nvasquezc/dc-motor-fault-detection/docs/fig01_caracteristica.png

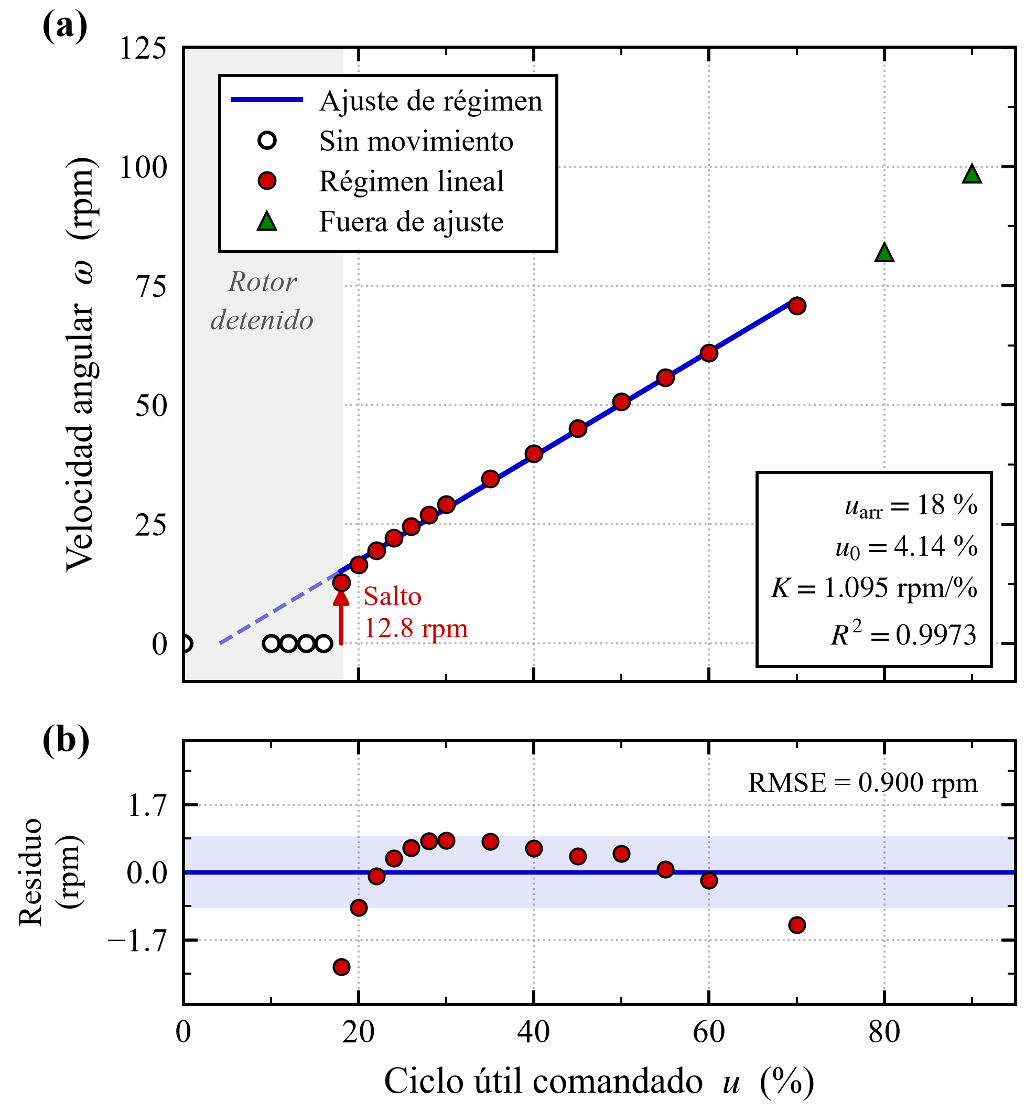
docs/fig01_caracteristica.png
