nvasquezc/dc-motor-fault-detection/docs/fig02_metrologia.png

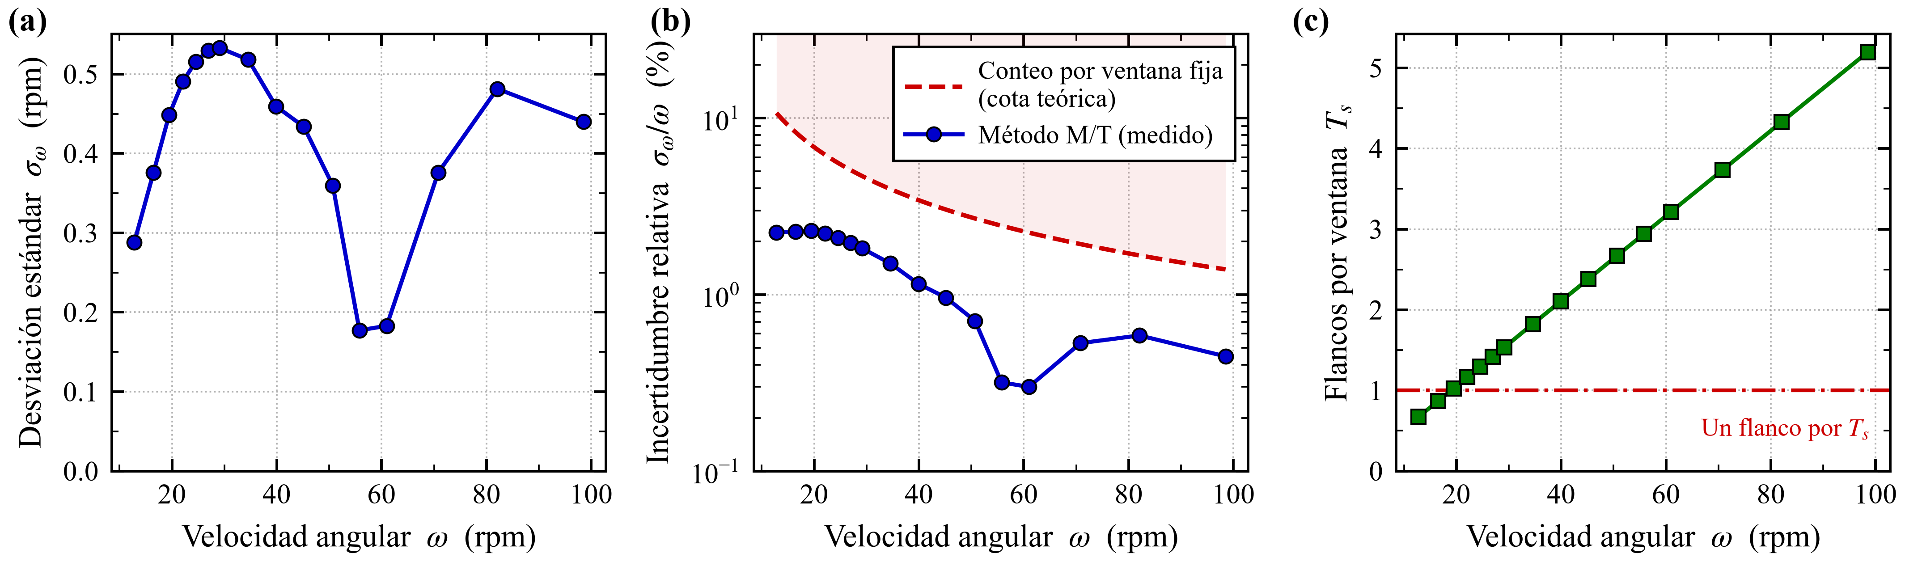
docs/fig02_metrologia.png
