nvasquezc/dc-motor-fault-detection/docs/fig03_escalon.png

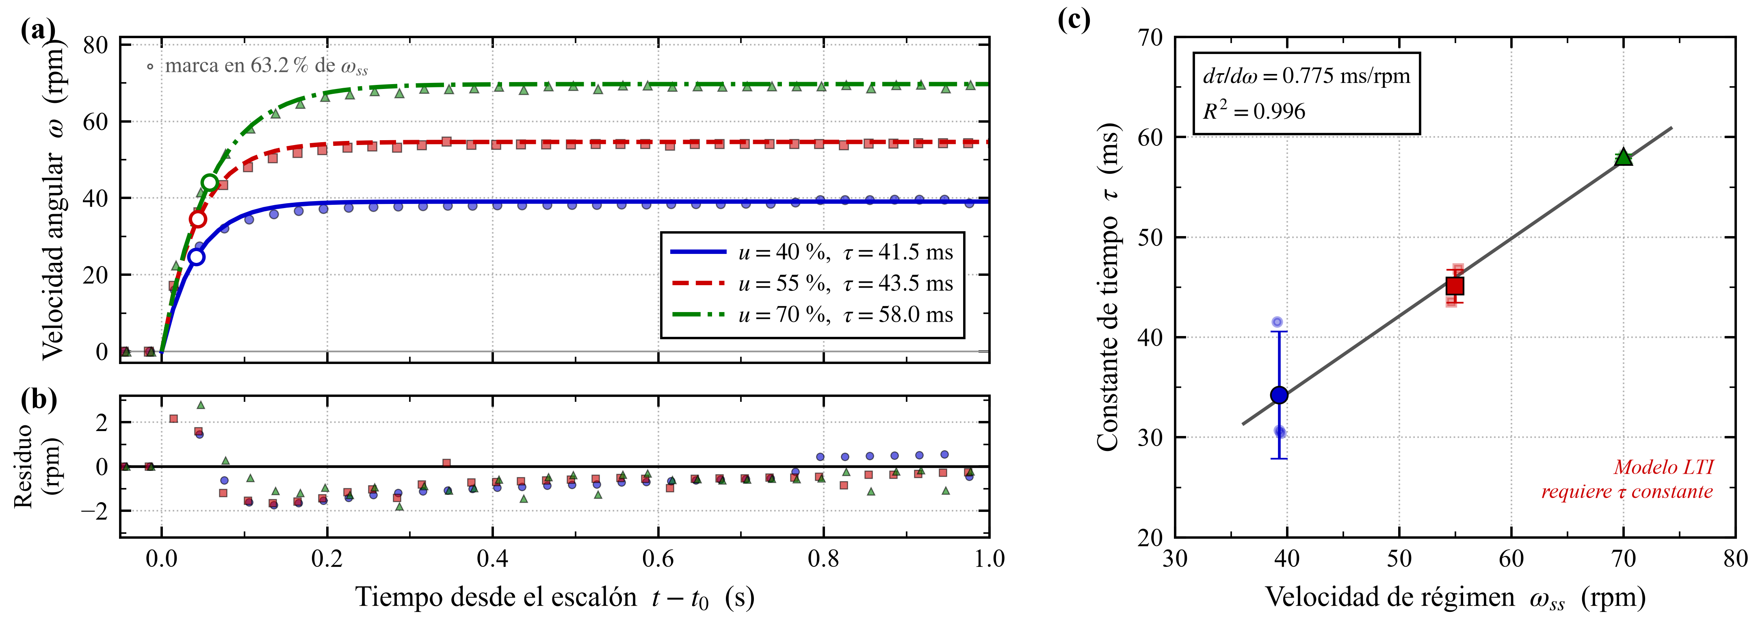
docs/fig03_escalon.png
