nvasquezc/dc-motor-fault-detection/docs/fig04_deriva1.png

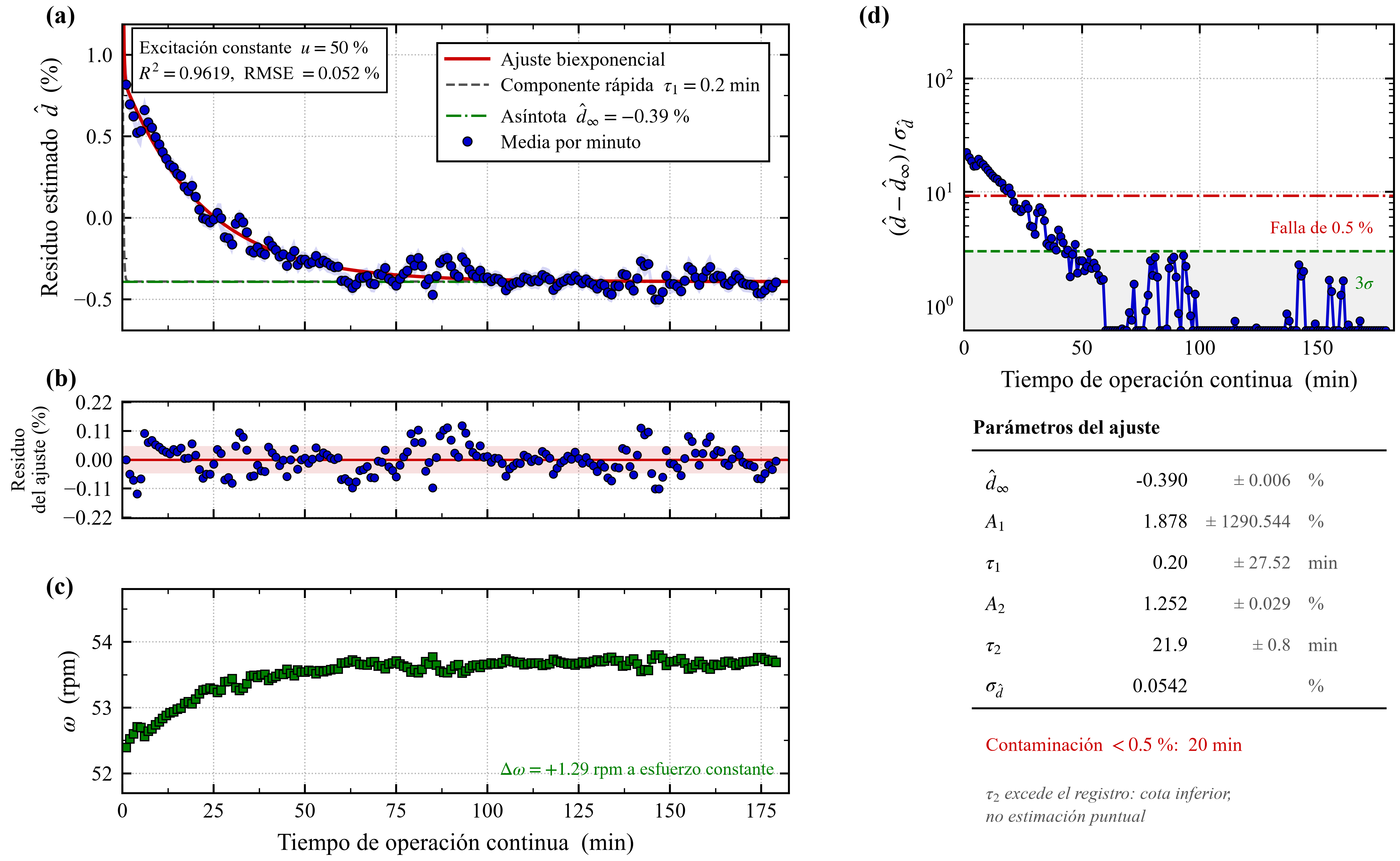
docs/fig04_deriva1.png
