nvasquezc/dc-motor-fault-detection/docs/fig04_deriva2.png

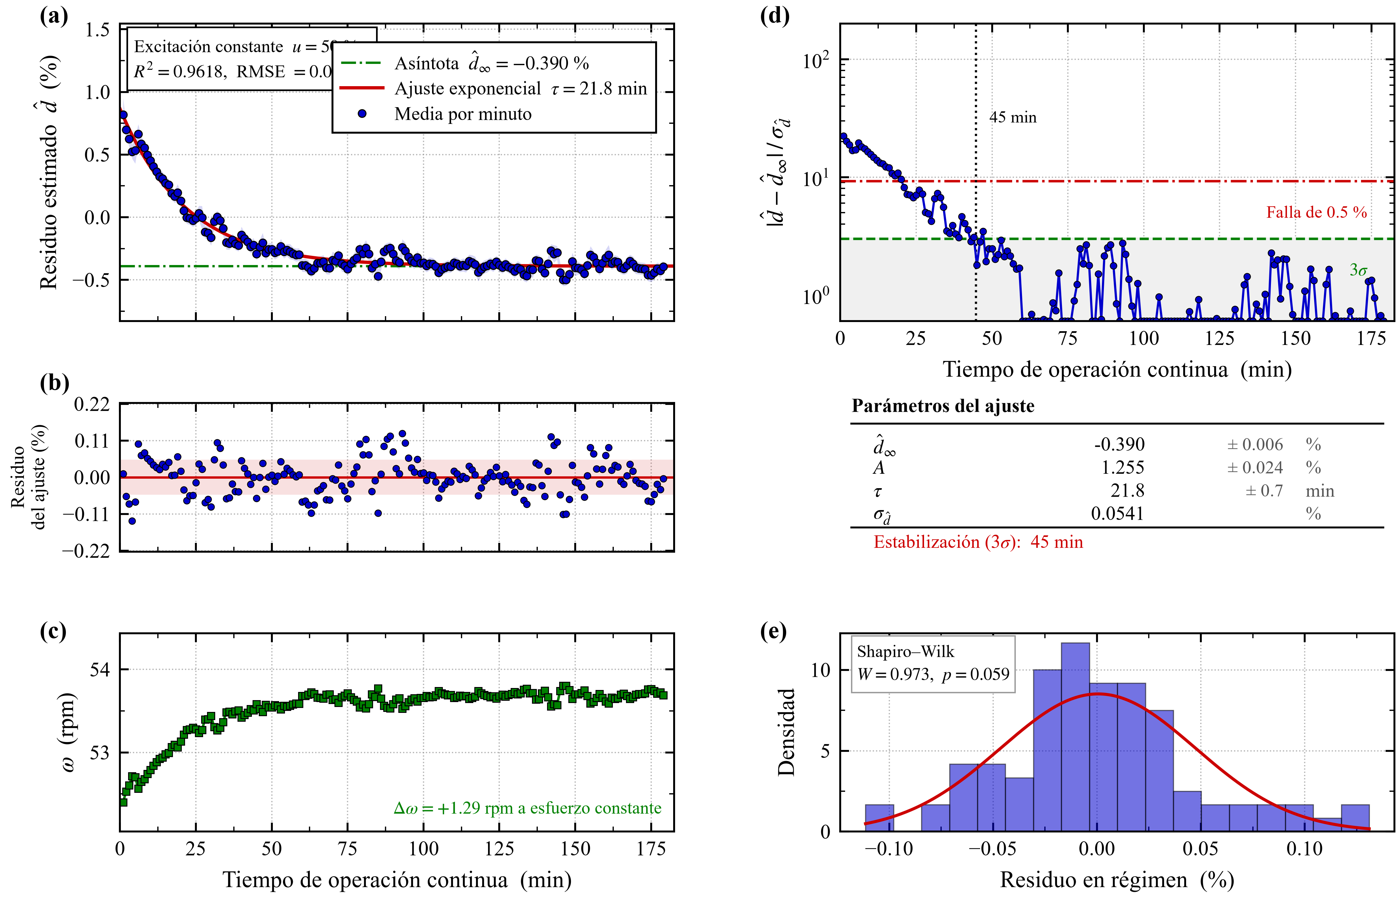
docs/fig04_deriva2.png
