nvasquezc/dc-motor-fault-detection/docs/fig04_deriva.png

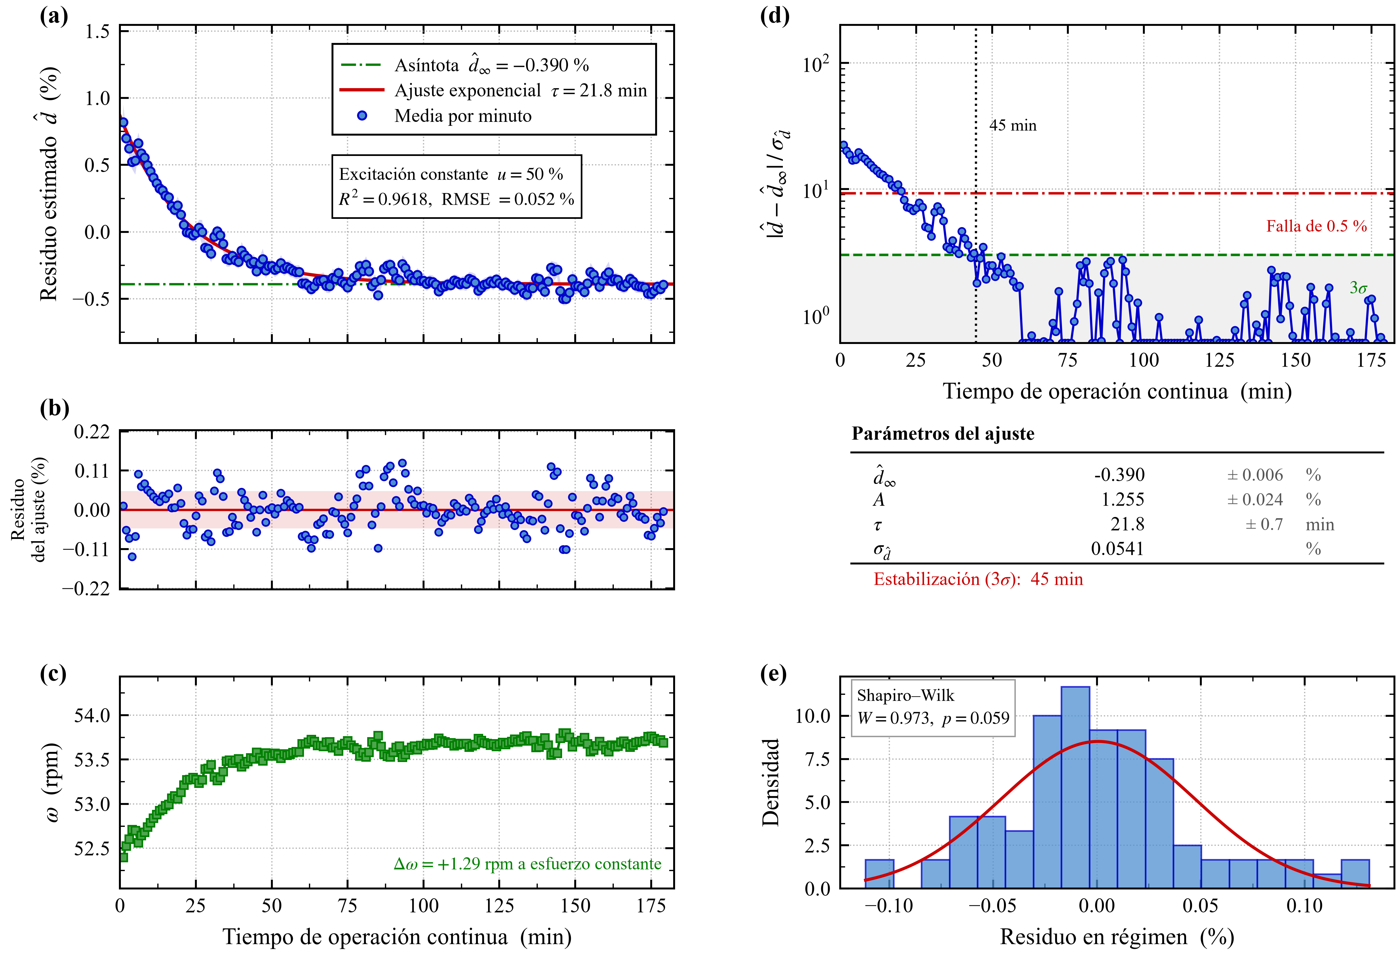
docs/fig04_deriva.png
