nvasquezc/dc-motor-fault-detection/docs/fig01_caracteristica.pdf

(a)

## Régimen lineal Fuera de ajuste Rotor

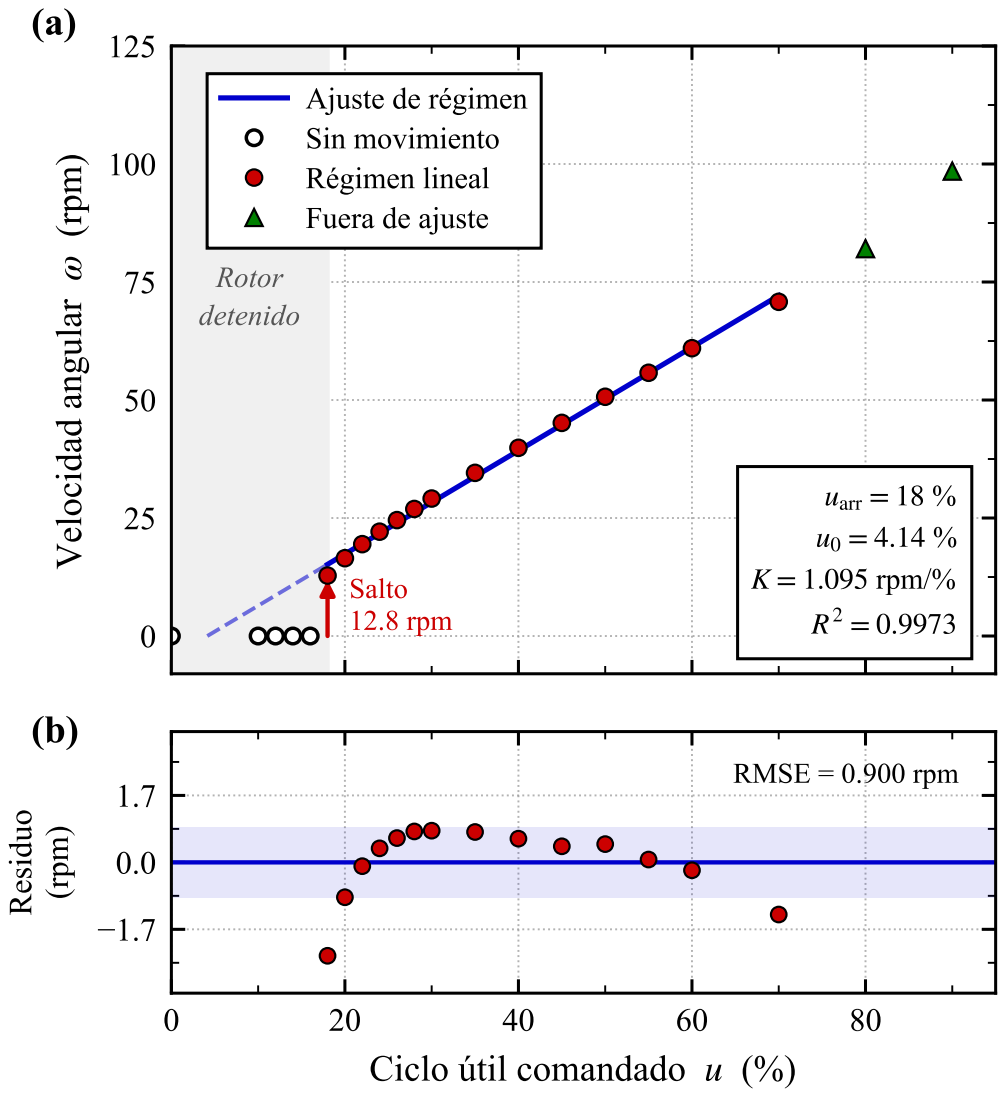
[picture p7: page 1]
Residuo; (rpm); RMSE = 0.900 rpm

Ajuste de régimen Sin movimiento

Velocidad angular ω (rpm)

detenido

uarr = 18 %

Salto 12.8 rpm | u0 = 4.14 % K = 1.095 rpm/% 2 = 0.9973 R

Ciclo útil comandado u (%)
