nvasquezc/dc-motor-fault-detection/docs/fig02_metrologia.pdf

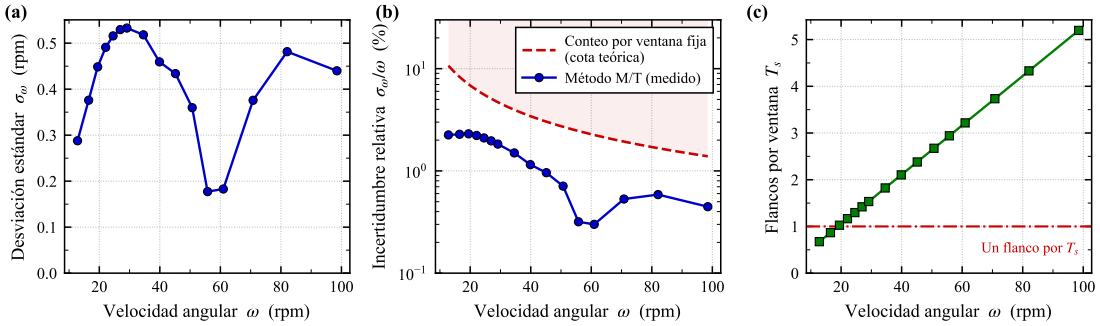
[picture p8: page 1]
100 Velocidad angular ω (rpm)

Incertidumbre relativa σω/ω (%)

Desviación estándar σω (rpm)

Conteo por ventana fija
(cota teórica)
Método M/T (medido)

Flancos por ventana Ts
