nvasquezc/dc-motor-fault-detection/docs/fig03_escalon.pdf

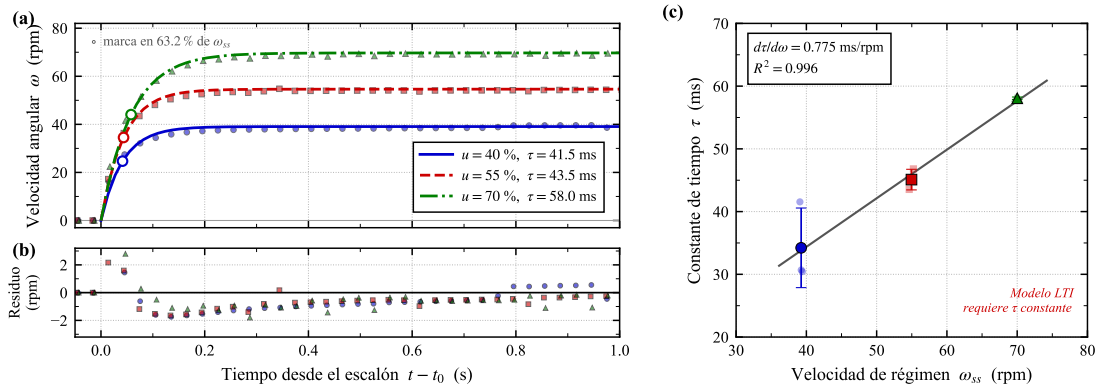
[picture p9: page 1]
1.0 Tiempo desde el escalón t − t0 (s); Residuo; (rpm); 80 Velocidad de régimen ωss (rpm); Modelo LTI

Velocidad angular ω (rpm)

Constante de tiempo τ (ms)

u = 4 0 % u % | , τ = 4 1 . 5 m s , τ m s
= 5 5 u = 7 0 % | = 4 3 . 5 , τ = 5 8 . 0 m s
