nvasquezc/dc-motor-fault-detection/docs/fig04_deriva.pdf

(a)

(d)

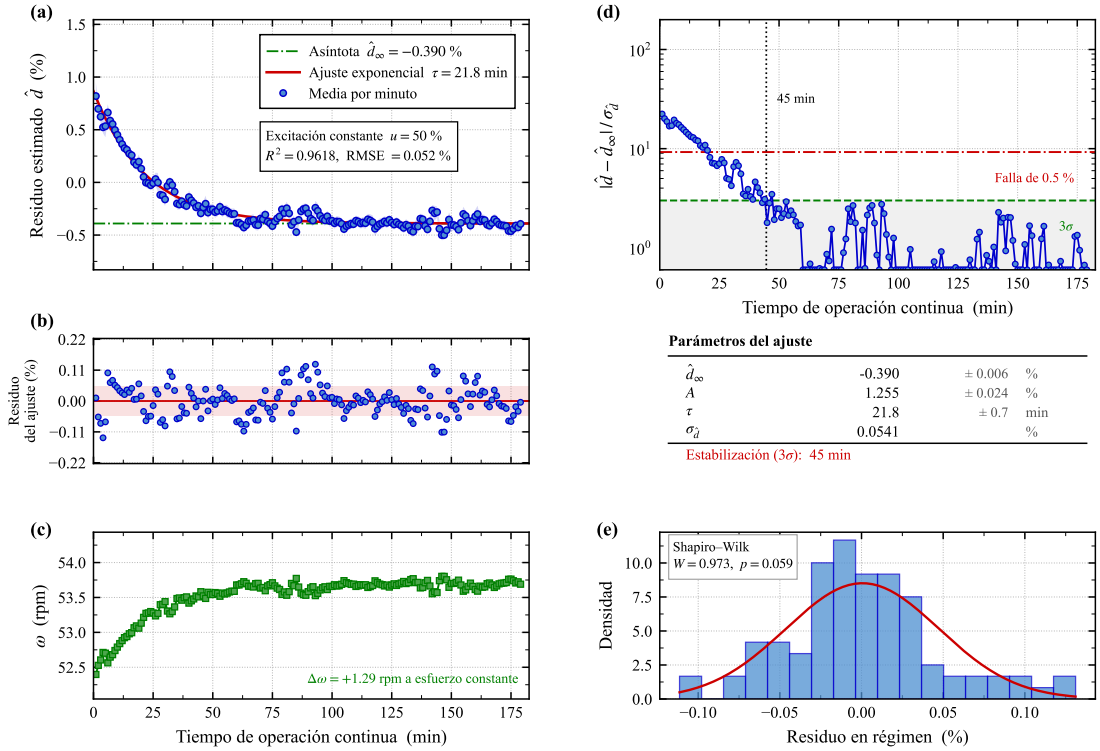
[picture p10: page 1]
Residuo estimado; Residuo; del ajuste (%); ω (rpm); Densidad; Shapiro–Wilk W = 0.973, p = 0.059; min; Estabilización (3σ): 45 min

Asíntota Ajuste exponencial τ = 21.8 min | ̂ d∞ = −0.390 %

Media por minuto

45 min

Excitación constante u = 50 % R | 2 = 0.9618, RMSE | | = 0.052 %

Falla de 0.5 %

Tiempo de operación continua (min)

Parámetros del ajuste

Δω = +1.29 rpm a esfuerzo constante

Residuo en régimen (%)
