nvasquezc/dc-motor-fault-detection/(commit log)

2026-09-03 Add STM32 firmware for MX observer
    [Observador Debug.cfg]
2026-09-03 Rewrite README in English; rename debug files; track launch config
    [observer-mx-debug.cfg]
2026-09-03 Rewrite README in English; rename debug files; track launch config; Citation
2026-09-03 Correct filter description: linear KF with disturbance state, not EKF
2026-09-08 feat: scripts de ensayo y protocolo de telemetria
2026-09-10 feat: identificacion estatica y figuras de publicacion
    - Barrido duty->RPM con 21 puntos, 6329 muestras, 0 glitches
    - K = 1.0654 +/- 0.0095 rpm/%, R2 = 0.99928, RMSE = 0.42 rpm
    - Umbral de arranque 24%, salto de 21.24 rpm: friccion estatica
    tipo Stribeck, no zona muerta clasica
    - sigma M/T = 0.35 rpm frente a 1.37 rpm de la cota teorica del
    conteo por ventana fija (mejora de 3.9x)
    - Figuras con convencion de control: marco cerrado, grid punteado
    [identificacion.py]
2026-09-10 feat: figuras del ensayo de escalon
    - Respuestas temporales con ajuste exponencial y marca en 63.2%
    - Panel de residuos por amplitud
    - Dependencia tau vs punto de operacion con regresion
    Hallazgo: tau crece de 34.2 a 58.1 ms entre 40 y 70 % de duty.
    El amortiguamiento efectivo B_ef = J/tau decrece con la velocidad,
    consistente con la friccion de Stribeck ya evidenciada por el salto
    de arranque de 21.24 rpm en el barrido estatico. El supuesto LTI
    del modelo nominal no se cumple en todo el rango.
2026-09-10 fix: encoder QA/QB permutado y parametros del modelo identificados
    - mod_a = 0.196165, mod_b = 0.208994 (tau = 45.8 ms, K = 1.0654)
    - kf_R = 0.1227 rpm^2, medido en lugar de supuesto
    - Signo del encoder corregido en hardware: w_raw ahora positivo
    Observador validado en lazo abierto:
    D40 -> w_hat sigue a w_raw con error de decimas, d_hat = 2.5 %
    D70 -> w_hat sigue a w_raw con error de decimas, d_hat = 4.57 %
    Pendiente: d_hat depende del punto de operacion (2.5 a 4.6 %),
    en parte por error de modelado de tau. Requiere curva de linea
    base d_hat_sano(omega) para normalizar el observable.
    [main.c]
2026-09-10 feat: ensayo de deriva - la linea base cambia 49.5 sigma en 30 min
    d_hat: 3.34 -> 0.43 % con duty constante en 50 %
    w_raw: 49.4 -> 52.8 rpm
    La deriva no se estabiliza en 30 min. Requiere diseño experimental
    balanceado y registro del tiempo de operacion como covariable.
    Pendiente: canal de corriente reporta valor congelado (5.9629 A),
    verificar montaje de resistencias en R_IS/L_IS.
2026-09-10 feat: ensayo de deriva extendido a 3 h y correcciones de figura
2026-09-11 feat: ensayo de deriva extendido a 3 h y correcciones de figura 4d
